Safecast/bGeigieNanoS/(list of files, drawings)

Other design files:
assembly/bGeigieNanoKit.fzz
fristzing files/board.fzz
fristzing files/nGeigieTeensy.fzz
