Safecast/bGeigieNanoS/hardware/bGeigieNanoKit/bGeigieNanoKit.brd

## EAGLE design hardware/bGeigieNanoKit/bGeigieNanoKit.brd (2014-10-25, last stored version)

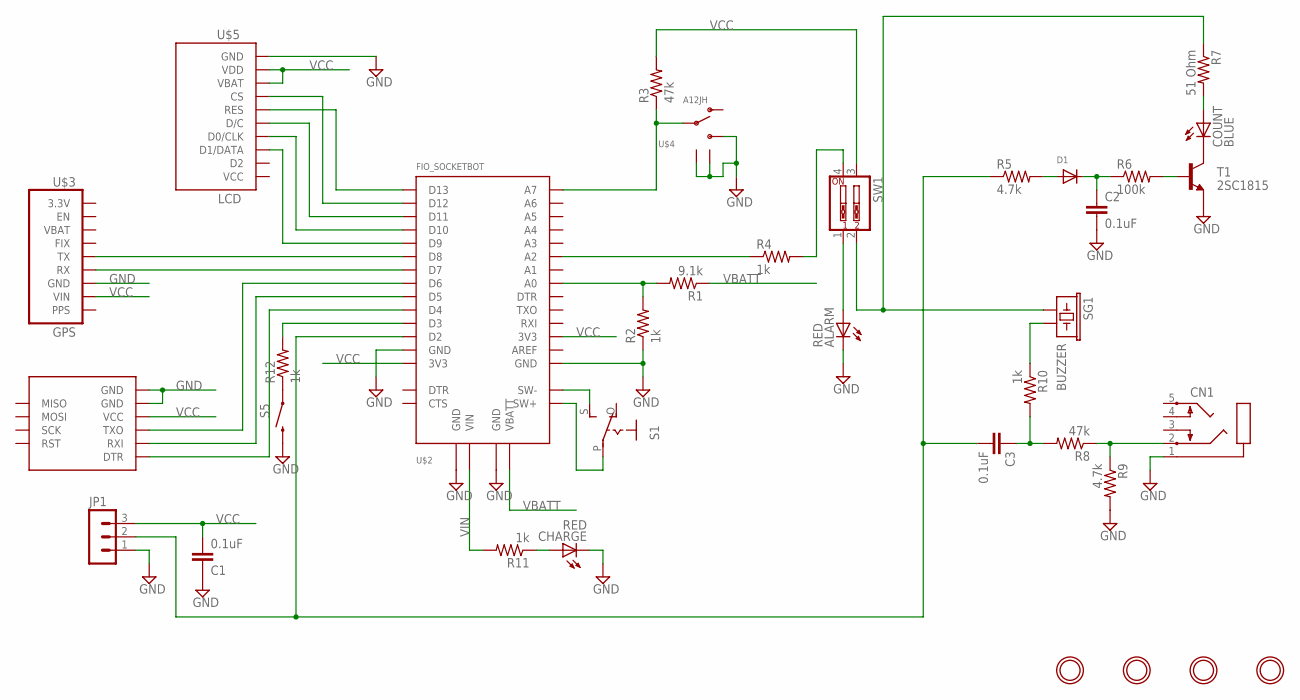
[picture p1: schematic bGeigieNanoKit.sch]

Parts:
ALARM: RED; LED3MM
C1, C2, C3: 0.1uF; C050-024X044
CHARGE: RED; LED3MM
CN1: AUDIO_STEREOJACK; STX3100
COUNT: BLUE; LED3MM
D1: DIODEDO-1N4148; DO-1N4148
JP1: MA03-1
R1: 9.1k; 0207/10
R2, R4, R10, R11, R12: 1k; 0207/10
R3, R8: 47k; 0207/10
R5, R9: 4.7k; 0207/10
R6: 100k; 0207/10
R7: 51 Ohm; 0207/10
S1: EG1218S; EG1218
S5: SWITCH-MOMENTARY-2PTH; TACTILE-PTH
SG1: BUZZER; BUZZER-12MM
SW1: SW_DIP-2; EDG-02
T1: 2SC1815; TO92-ECB
U$1: OPENLOG
U$2: FIO_SOCKETBOT; FIO_V23_SOCKET_BOT
U$3: GPS; ULTIMATE_GPS_V3_TOP
U$4: A12JH; A12AH
U$5: LCD; SSD1306_128X64_LCD_MIN
U$6, U$7, U$8, U$9: MOUNTINGHOLE3.0THIN; MOUNTINGHOLE_3.0_PLATEDTHIN

Connections:
GND: ALARM.K (C), C1.1, C2.2, CHARGE.K (C), CN1.1, JP1.1, R2.1, R9.2, S5.3 (2), T1.E, U$1.JP1$5 (GND), U$1.JP1$6 (GND), U$2.JP1$2 (GND), U$2.JP2$1 (GND), U$2.JP5$1 (GND), U$2.JP6$1 (GND), U$3.JP1$3 (GND), U$3.U$8$P$1 (GND), U$3.U$9$P$1 (GND), U$4.P$3, U$4.P$4 (GND), U$4.P$5 (GND), U$5.P0\$10 (GND)
unnamed: U$2.JP1$10 (D9), U$5.P0\$3 (D1/DATA)
unnamed: U$2.JP1$11 (D10), U$5.P0\$4 (D0/CLK)
unnamed: U$2.JP1$12 (D11), U$5.P0\$5 (D/C)
unnamed: U$2.JP1$13 (D12), U$5.P0\$7 (CS)
unnamed: U$2.JP1$14 (D13), U$5.P0\$6 (RES)
unnamed: U$2.JP1$9 (D8), U$3.JP1$5 (TX)
unnamed: U$2.JP1$8 (D7), U$3.JP1$4 (RX)
unnamed: U$1.JP1$3 (TXO), U$2.JP1$7 (D6)
unnamed: U$1.JP1$2 (RXI), U$2.JP1$6 (D5)
unnamed: U$1.JP1$1 (DTR), U$2.JP1$5 (D4)
unnamed: R1.2, R2.2, U$2.JP5$7 (A0)
unnamed: S1.P, U$2.JP7$2 (SW+)
unnamed: S1.S, U$2.JP7$1 (SW-)
unnamed: R3.1, U$2.JP5$14 (A7), U$4.P$2
unnamed: R4.1, U$2.JP5$9 (A2)
unnamed: ALARM.A, SW1.1
unnamed: R4.2, SW1.4
unnamed: C3.2, JP1.2, R5.1, U$2.JP1$3 (D2)
unnamed: COUNT.A, R7.2
unnamed: R12.1, S5.1
unnamed: R7.1, SG1.+ (1), SW1.2
unnamed: COUNT.K (C), T1.C
unnamed: R10.1, SG1.- (2)
unnamed: C3.1, R8.2, R10.2
unnamed: CN1.2, R8.1, R9.1
unnamed: D1.A, R5.2
unnamed: C2.1, D1.C, R6.1
unnamed: R6.2, T1.B
unnamed: CHARGE.A, R11.1
unnamed: R12.2, U$2.JP1$4 (D3)
VBAT: U$3.JP1$7 (VBAT)
VBATT: R1.1, U$2.JP2$2 (VBATT)
VCC: C1.2, JP1.3, R3.2, SW1.3, U$1.JP1$4 (VCC), U$2.JP1$1 (3V3), U$2.JP5$3 (3V3), U$3.JP1$2 (VIN), U$5.P0\$1 (VCC), U$5.P0\$8 (VBAT), U$5.P0\$9 (VDD)
VIN: R11.2, U$2.JP6$2 (VIN)

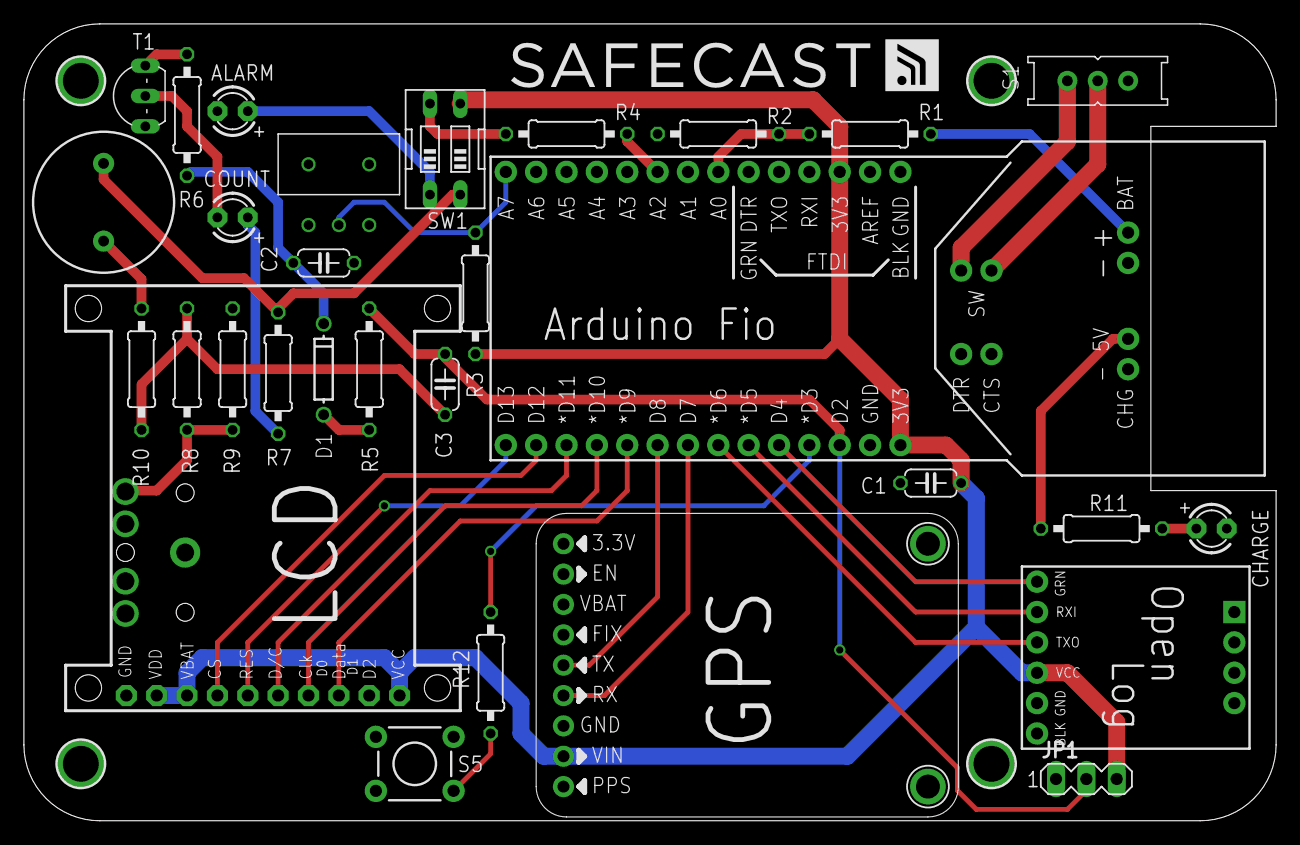
[picture p2: board bGeigieNanoKit.brd from above]

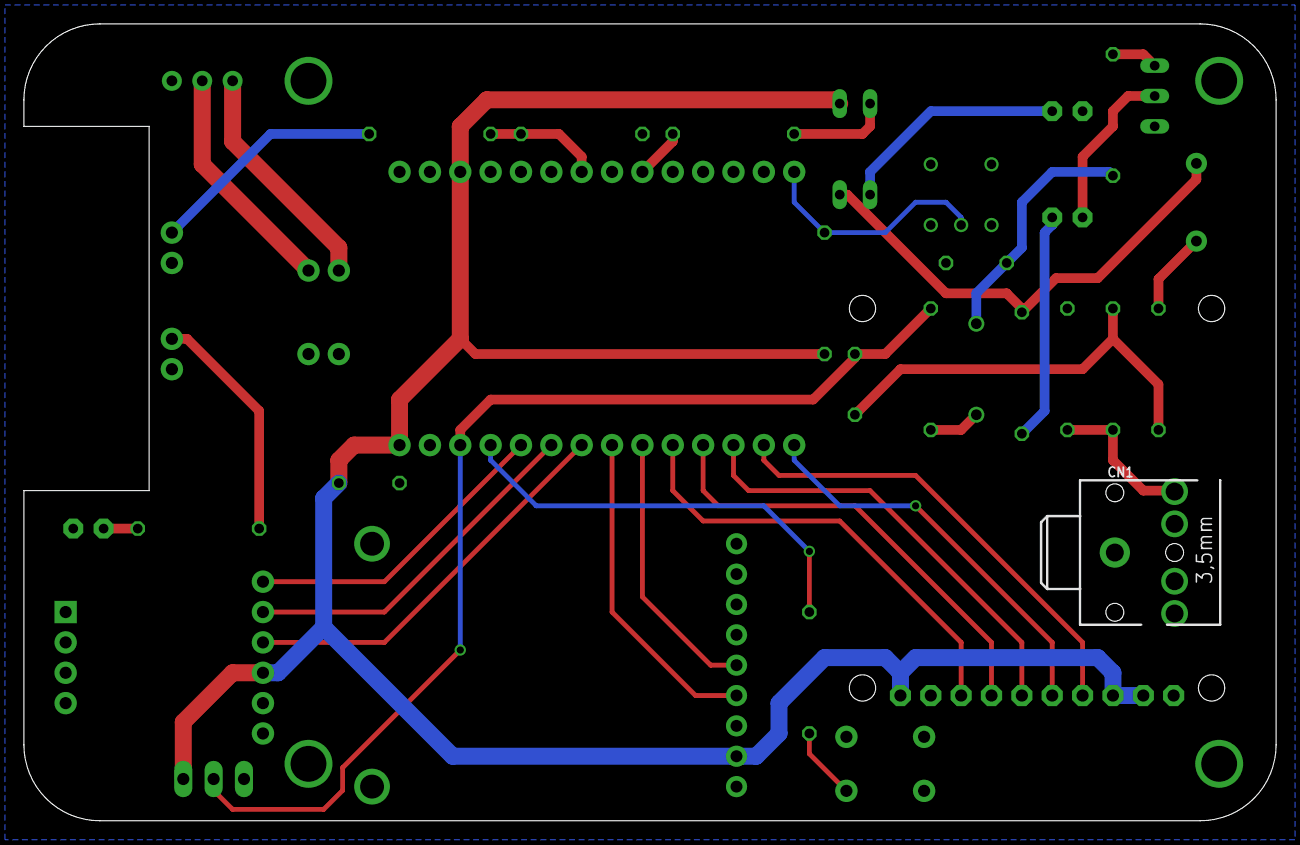
[picture p3: board bGeigieNanoKit.brd from below]

Board: 2 copper layers, 104.8 x 66.7 mm, 36 parts (2 on the bottom side), 34 nets.

Other parts of the board:
U$10: SAFECAST_LOGO1
